WeisTekEng/MicroNumitron/README.md

# MicroNumitron
Source code / hardware files for Had.io square inch project.
