WeisTekEng/MicroNumitron/(list of files, drawings)

Other design files:
Trunk/Hardware/Micro.SchDoc
Trunk/Hardware/NumiClockMicro.PcbDoc
Trunk/Hardware/NumiClockMicro.PrjPcb
Trunk/Hardware/Power.SchDoc
