WeisTekEng/MicroNumitron/(commit log)

2015-10-25 Massive FW overhaul.
    Almost all delays are gone except really short ones < 10ms all have been
    replaced by sleep.
    The cpu is interrupted every 1s checks everything goes back to sleep.
    time is displaying correctly and temp sensor are now working properly.
    [DS1337.cpp, DS1337.h, main.cpp]
2015-11-12 Huge FW upgrade.
    added tube display menu system, disable auto time show (show time only
    when Next btn is pressed), added show or hide temperature display, set
    time and set alarm.
    General code clean up, (needs to be cleaned more.)
2015-12-08 Upload of production files.
    Schematics and board files are in altium, Gerbers work fine with
    oshpark, drill files are included.
    [Micro.SchDoc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]
2016-06-24 Update main.cpp
    added comment to later set pin states.
